Protonerd/DIYino/pictures/hasbro_LS_openDIYinoinChassis_zpsviki0zha.jpg

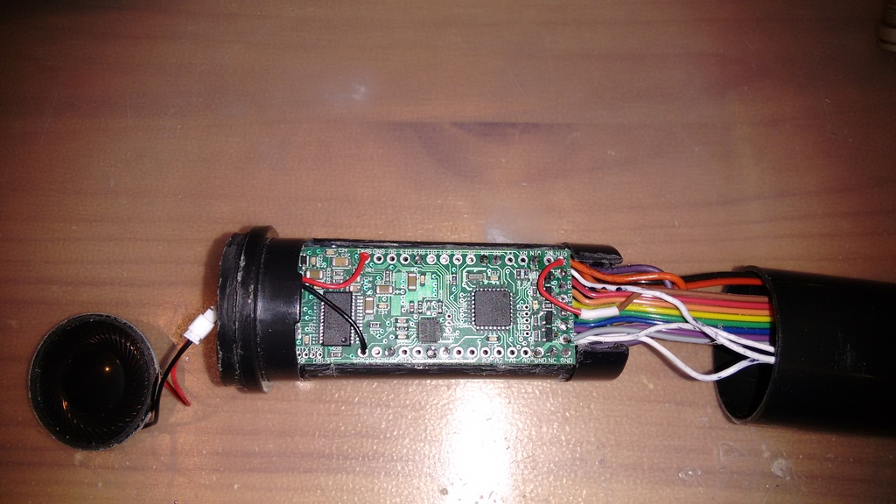
pictures/hasbro_LS_openDIYinoinChassis_zpsviki0zha.jpg
