Protonerd/DIYino/pictures/kicsi_IMG_20170122_215109895_00010_zpswzbyonry.jpg

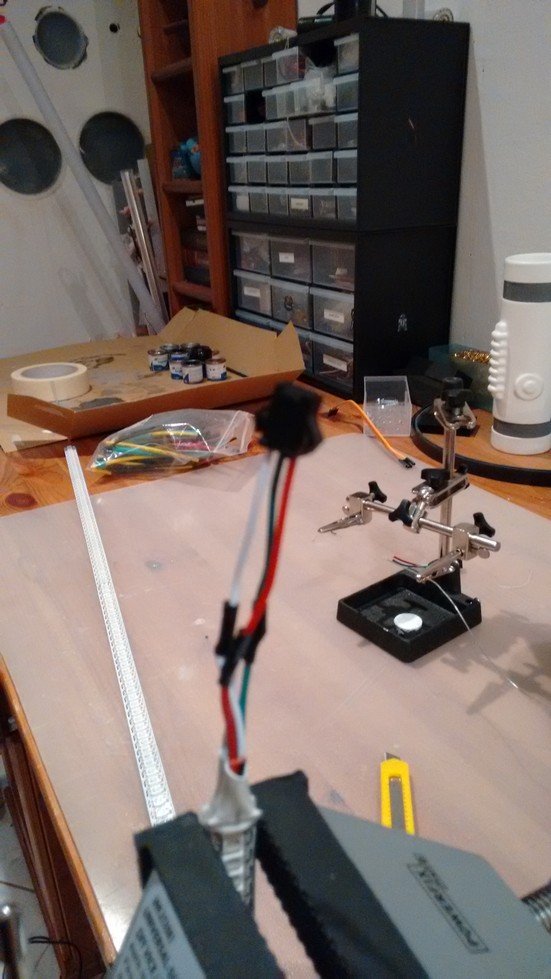
pictures/kicsi_IMG_20170122_215109895_00010_zpswzbyonry.jpg
