Protonerd/DIYino/pictures/Blaster_Display_Layout_zpsyfktzud1.jpg

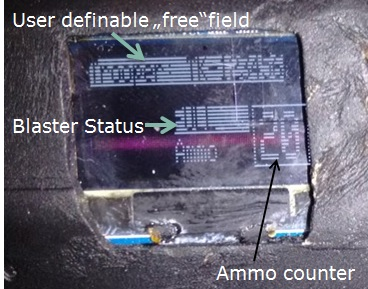
pictures/Blaster_Display_Layout_zpsyfktzud1.jpg
