Protonerd/DIYino/pictures/DIYino_1v5_1_zps3bcdqgek.jpg

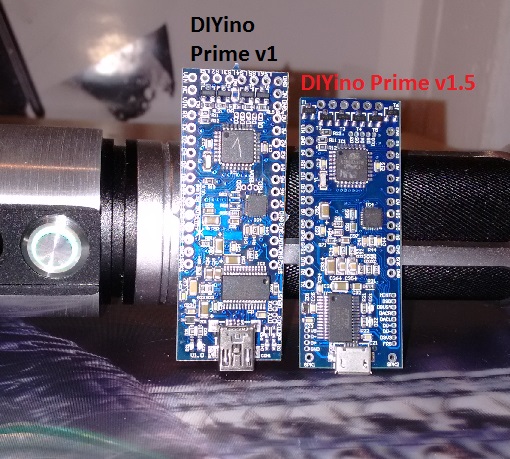
pictures/DIYino_1v5_1_zps3bcdqgek.jpg
