Protonerd/DIYino/pictures/DIYino_1v5_2_zpsymannivk.jpg

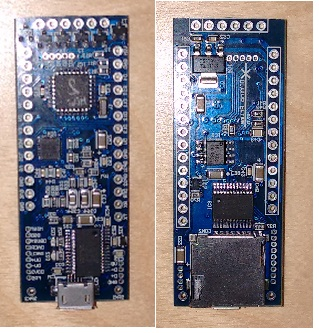
pictures/DIYino_1v5_2_zpsymannivk.jpg
