Protonerd/DIYino/pictures/DIYino_blaster_modules_zps4i7b7zbh.jpg

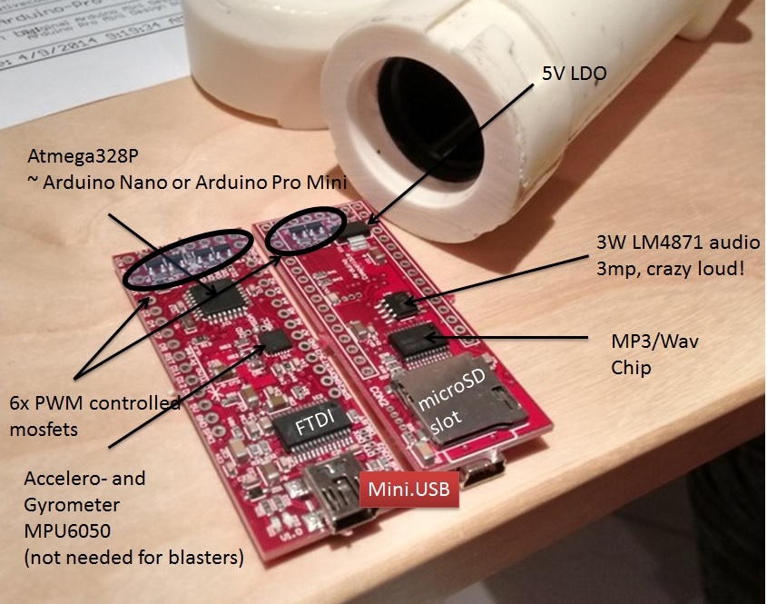
pictures/DIYino_blaster_modules_zps4i7b7zbh.jpg
