Protonerd/DIYino/pictures/DIYino_placement_v1_zpsvjuz00kw.jpg

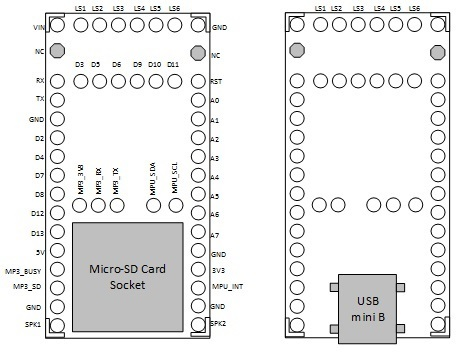
pictures/DIYino_placement_v1_zpsvjuz00kw.jpg
