Protonerd/DIYino/pictures/DIYino_Stardustv1_front_zpssht71tzs.jpg

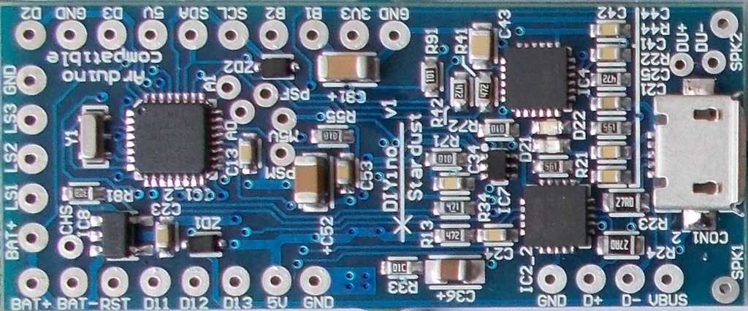
pictures/DIYino_Stardustv1_front_zpssht71tzs.jpg
