Protonerd/DIYino/pictures/DIYinobottom_zpsivflhri3.jpg

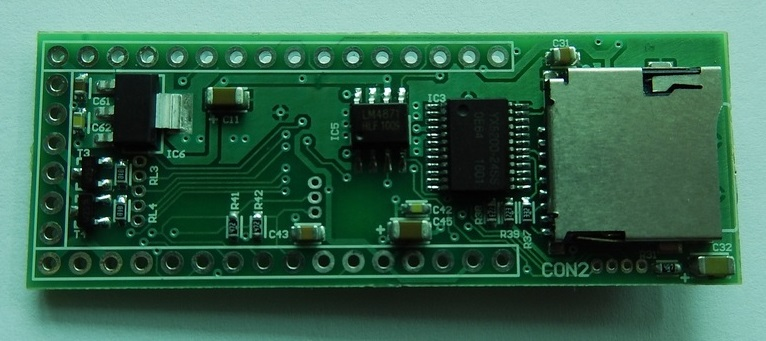
pictures/DIYinobottom_zpsivflhri3.jpg
