Protonerd/DIYino/pictures/DIYinotop_zpsscddceel.jpg

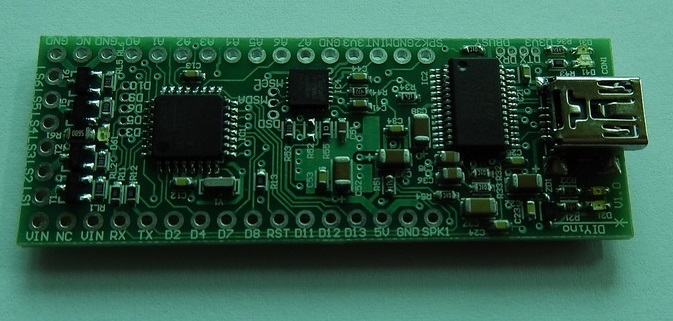
pictures/DIYinotop_zpsscddceel.jpg
