Protonerd/DIYino/pictures/DSC_4505_zpsdudptq5h.jpg

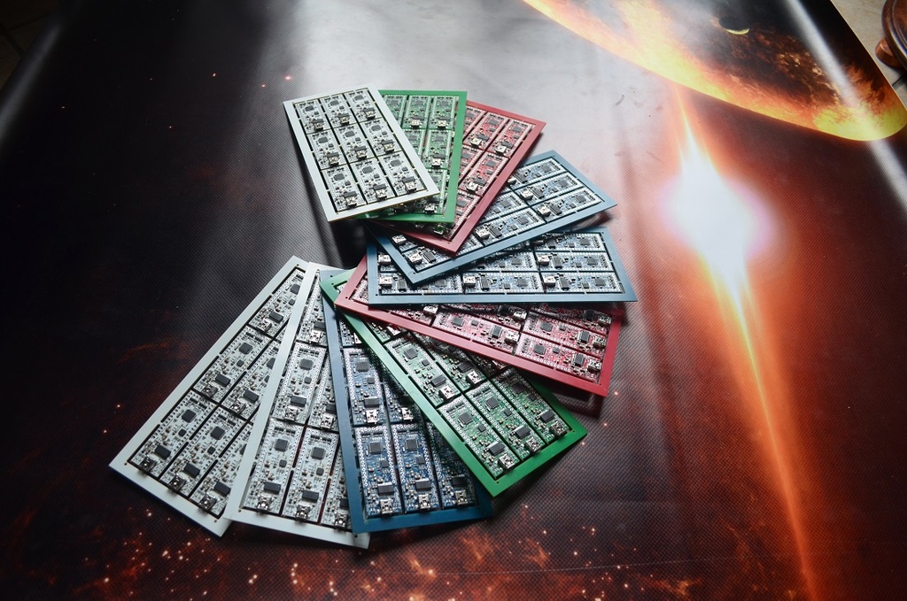
pictures/DSC_4505_zpsdudptq5h.jpg
