Protonerd/DIYino/pictures/DSC_4589 2_zpskc2gelkp.jpg

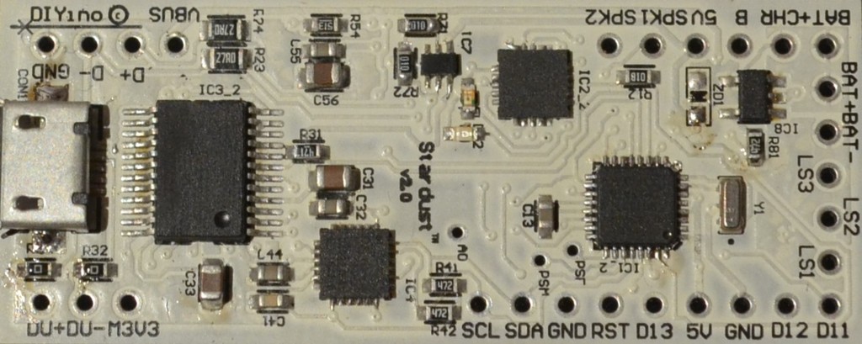
pictures/DSC_4589 2_zpskc2gelkp.jpg
