Protonerd/DIYino/pictures/DSC_4593 2_zpslnhpkdew.jpg

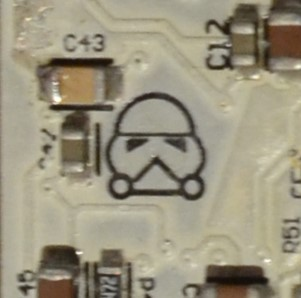
pictures/DSC_4593 2_zpslnhpkdew.jpg
