Protonerd/DIYino/pictures/DSC_4595 2_zpsk5upttnt.jpg

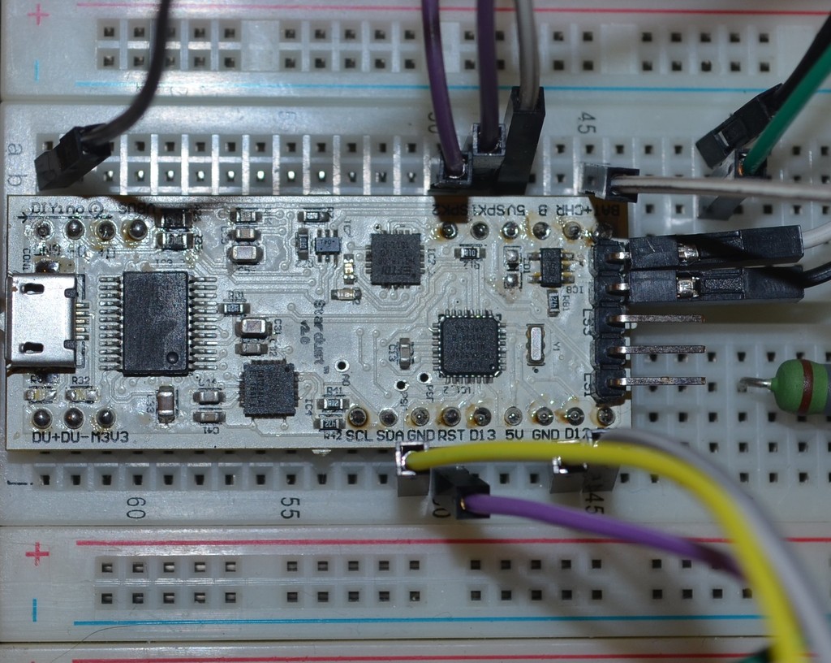
pictures/DSC_4595 2_zpsk5upttnt.jpg
