Protonerd/DIYino/pictures/DSCN0511_zpstvpl7wgr.jpg

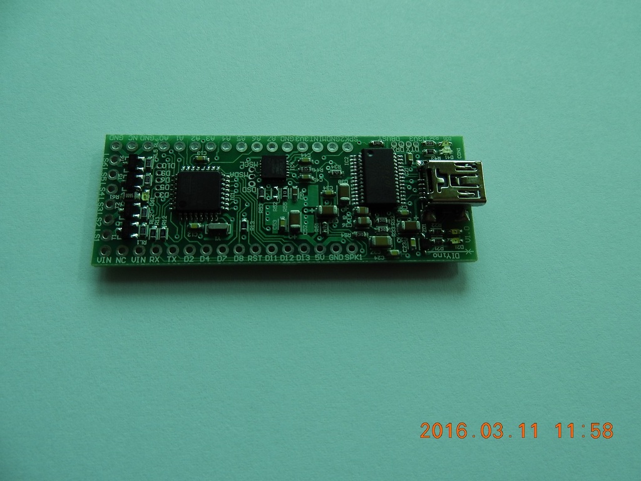
pictures/DSCN0511_zpstvpl7wgr.jpg
