Protonerd/DIYino/pictures/DSCN0513_zpsl67sjnq8.jpg

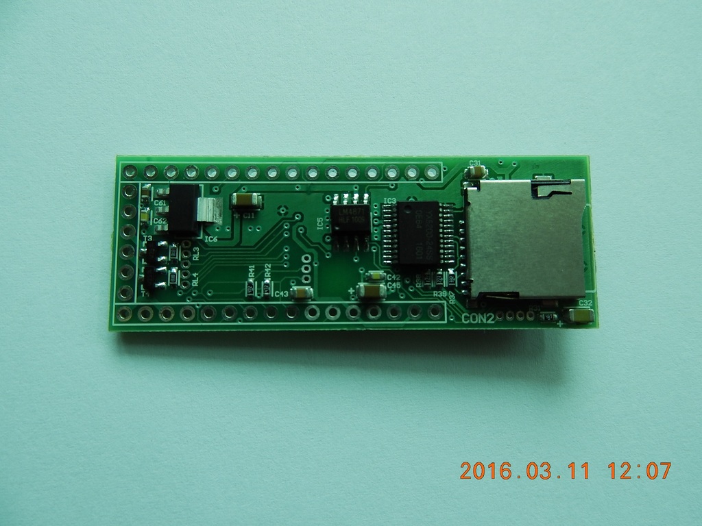
pictures/DSCN0513_zpsl67sjnq8.jpg
