Protonerd/DIYino/pictures/hasbro_LS_RCport_front_zpssrq27ork.jpg

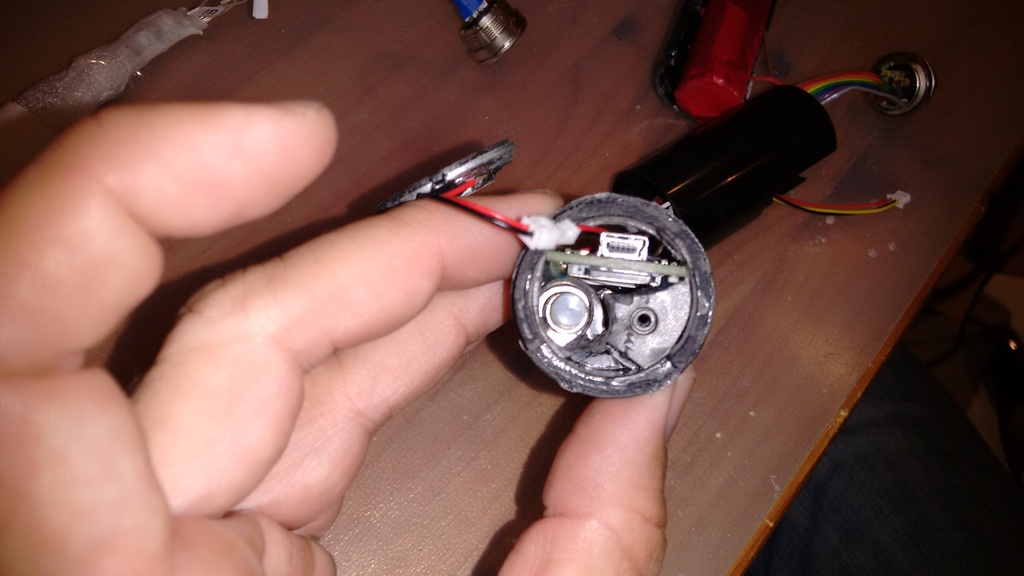
pictures/hasbro_LS_RCport_front_zpssrq27ork.jpg
