Protonerd/DIYino/pictures/IMG_20160215_192625701_zpswwhzhes4.jpg

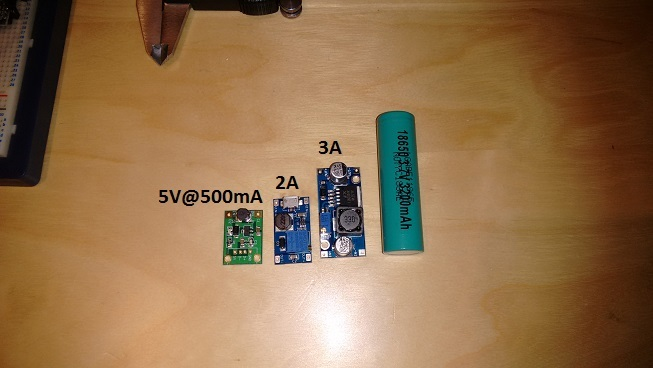
pictures/IMG_20160215_192625701_zpswwhzhes4.jpg
