Protonerd/DIYino/pictures/IMG_20160817_222459960_zpsyy1zh1ps.jpg

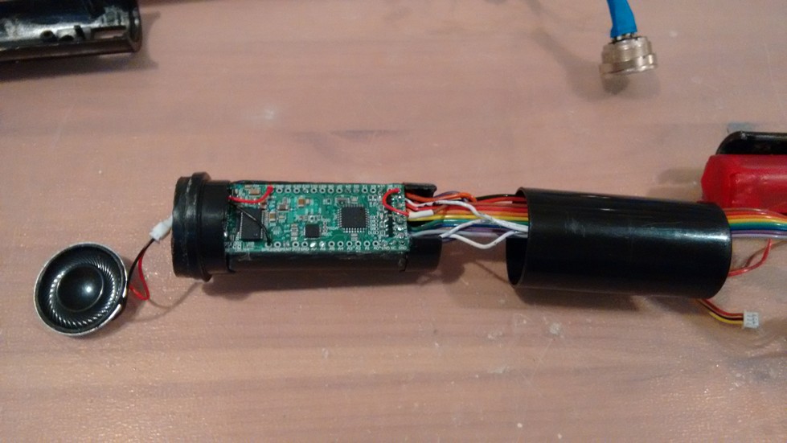
pictures/IMG_20160817_222459960_zpsyy1zh1ps.jpg
