Protonerd/DIYino/pictures/IMG_20160817_222520294_zpsochgfkhs.jpg

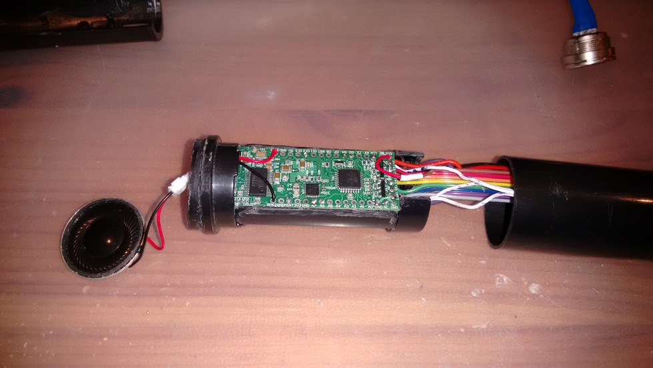
pictures/IMG_20160817_222520294_zpsochgfkhs.jpg
