Protonerd/DIYino/pictures/IMG_20160903_123718477_zpshqtb2i5k.jpg

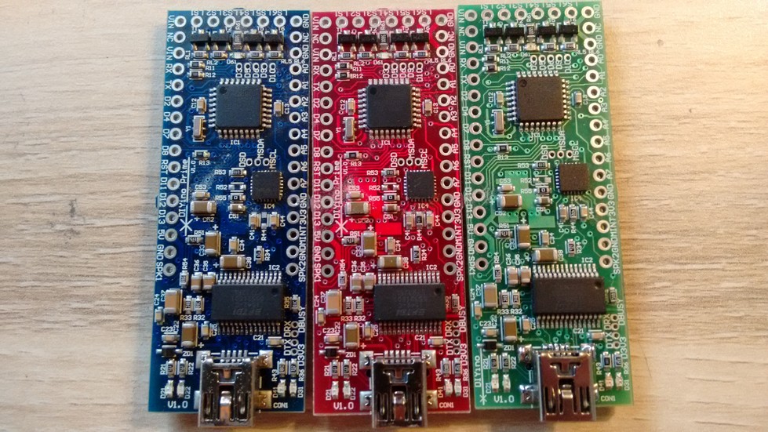
pictures/IMG_20160903_123718477_zpshqtb2i5k.jpg
