Protonerd/DIYino/pictures/IMG_20160903_124019020_zps9ozfazle.jpg

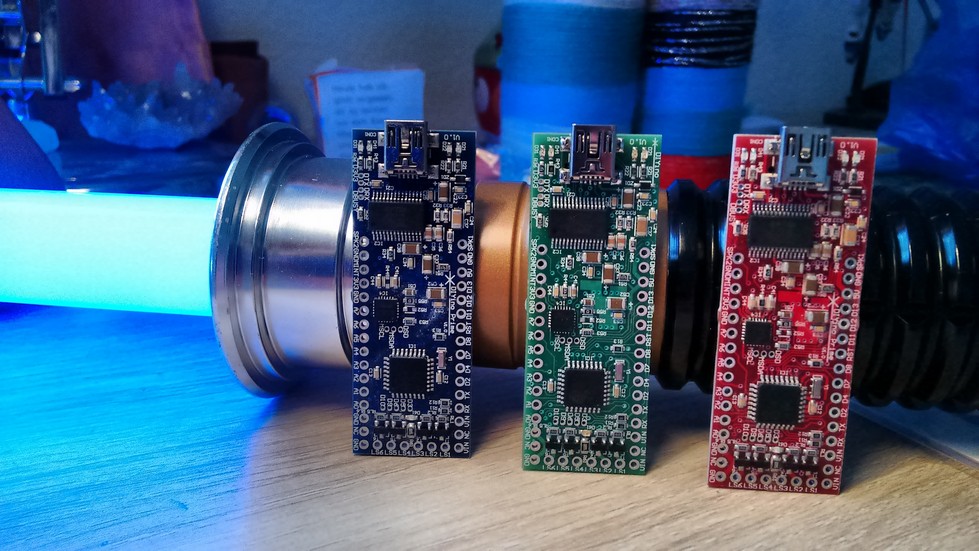
pictures/IMG_20160903_124019020_zps9ozfazle.jpg
