Protonerd/DIYino/pictures/IMG_20160903_124147270_HDR_zpsfaebn9b1.jpg

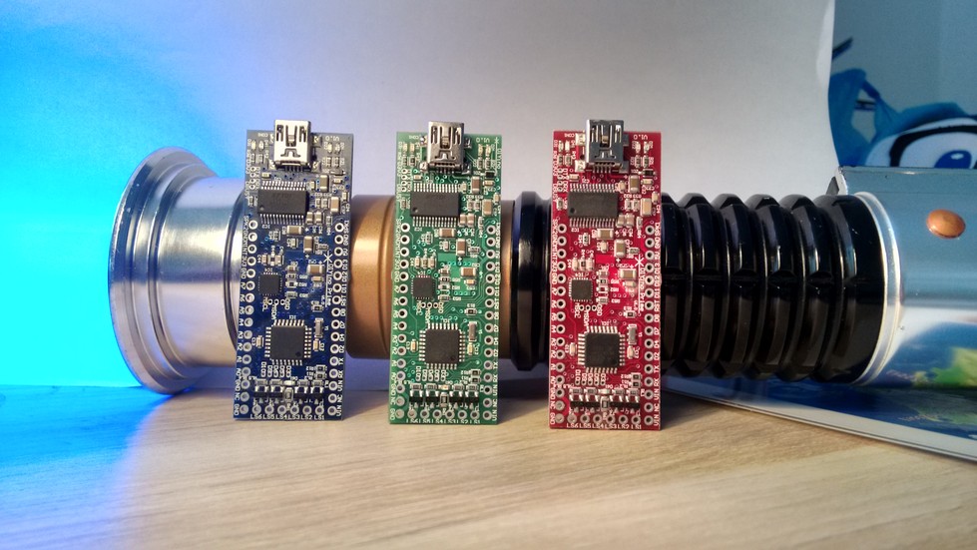
pictures/IMG_20160903_124147270_HDR_zpsfaebn9b1.jpg
