Protonerd/DIYino/pictures/IMG_20160903_190137795_zpsxg9ac361.jpg

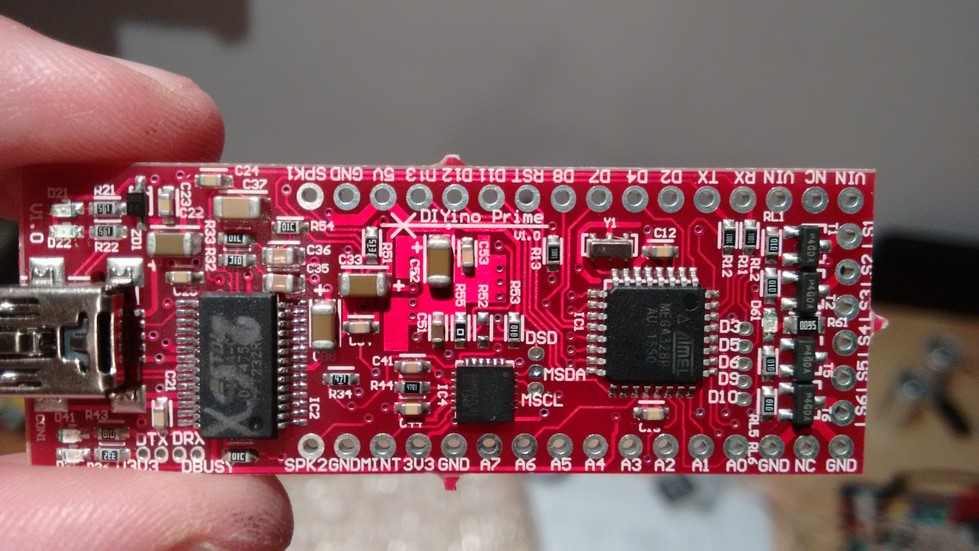
pictures/IMG_20160903_190137795_zpsxg9ac361.jpg
