Protonerd/DIYino/pictures/IMG_20170108_090120063_zps22bmebdj.jpg

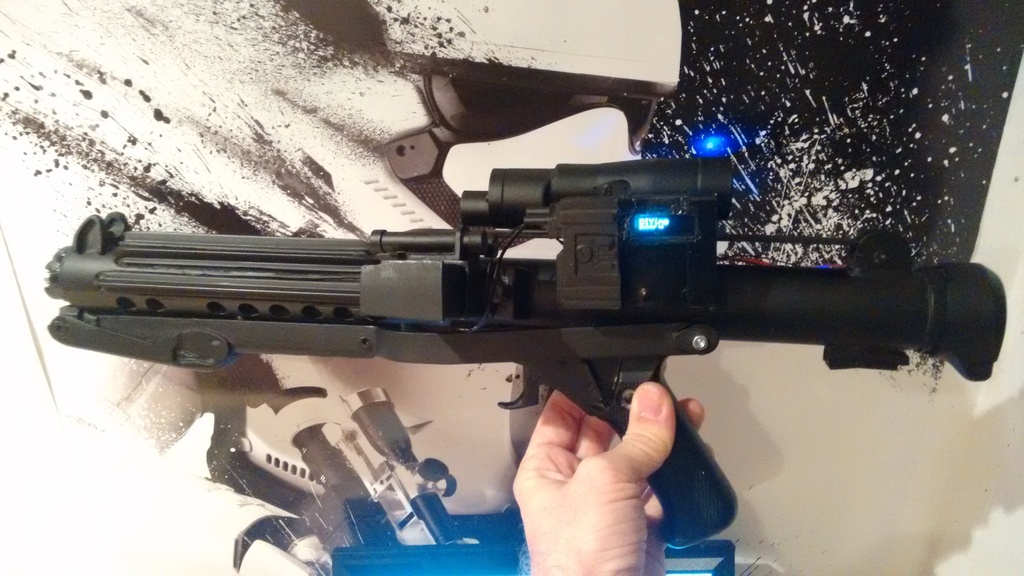
pictures/IMG_20170108_090120063_zps22bmebdj.jpg
