Protonerd/DIYino/pictures/IMG_20170108_090247453_zpsiayvx3zq.jpg

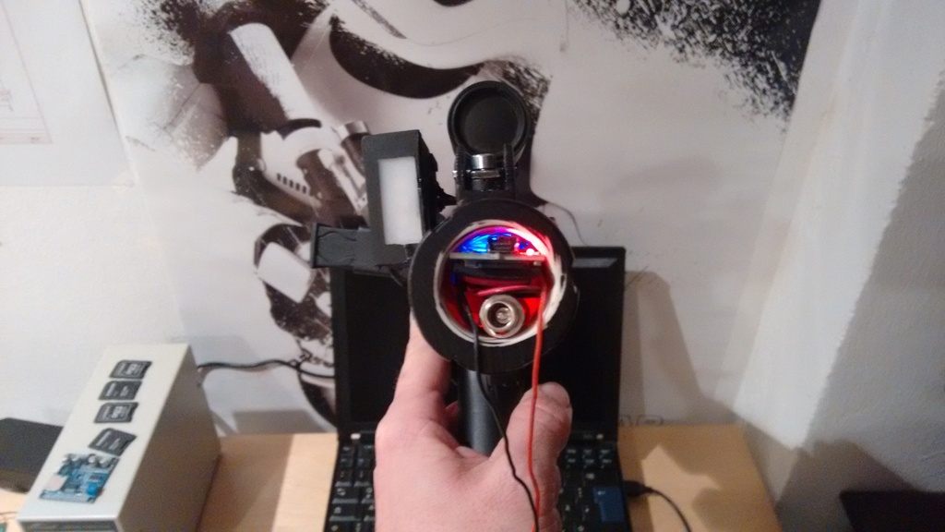
pictures/IMG_20170108_090247453_zpsiayvx3zq.jpg
