Protonerd/DIYino/pictures/IMG_20170303_185319780_zpsg4lbf3bk.jpg

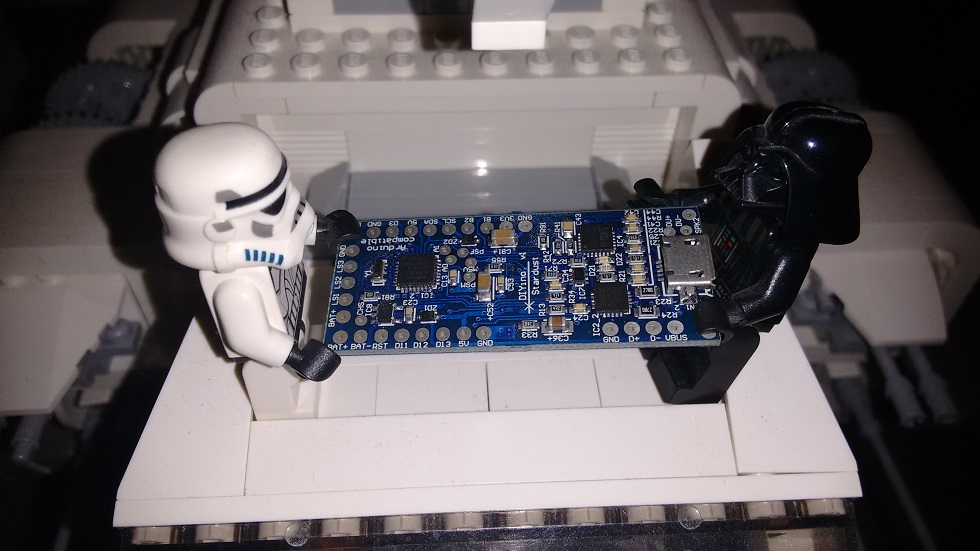
pictures/IMG_20170303_185319780_zpsg4lbf3bk.jpg
