Protonerd/DIYino/pictures/IMG_20170303_185423301_zpsorqcnlbd.jpg

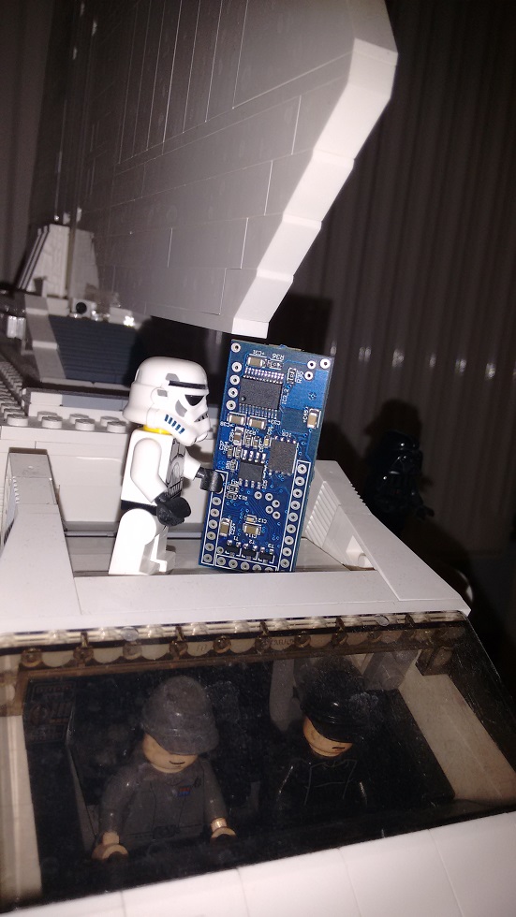
pictures/IMG_20170303_185423301_zpsorqcnlbd.jpg
