Protonerd/DIYino/pictures/IMG_20170303_185547586_zpsnakpmyop.jpg

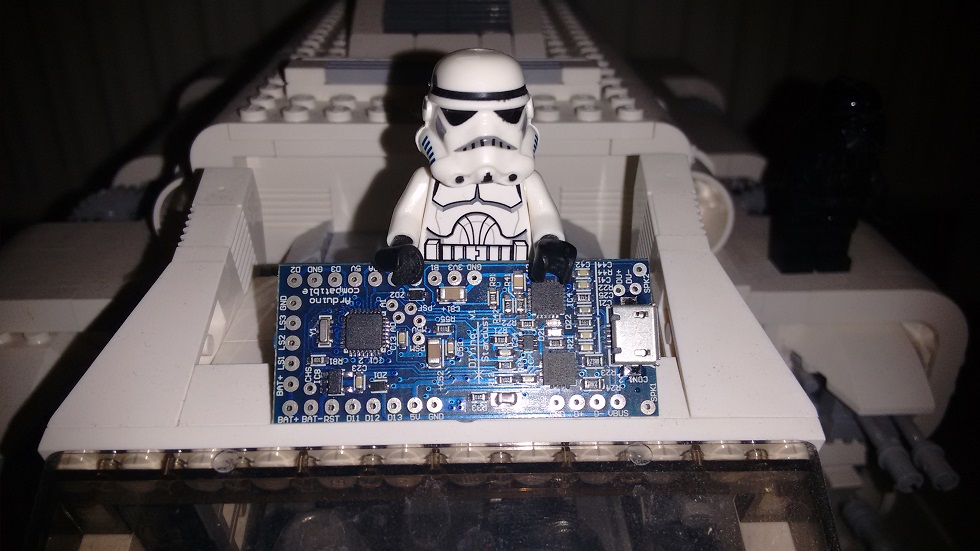
pictures/IMG_20170303_185547586_zpsnakpmyop.jpg
