Protonerd/DIYino/pictures/IMG_20170419_100204555_zps6a7qe6bl.jpg

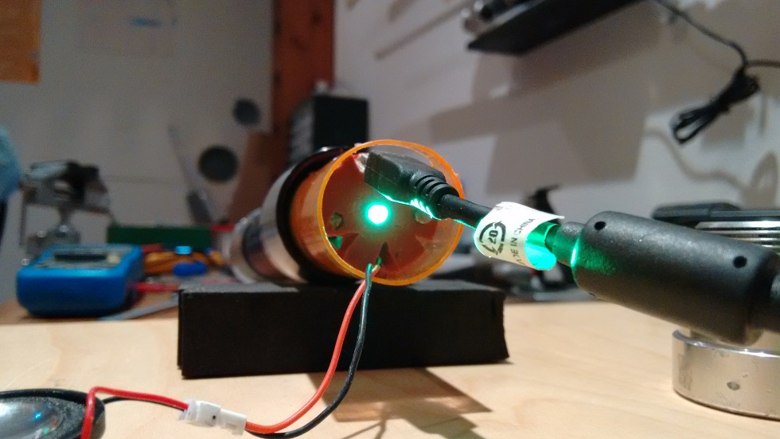
pictures/IMG_20170419_100204555_zps6a7qe6bl.jpg
