Protonerd/DIYino/pictures/IMG_20170419_100227607_zpsmmdsqt12.jpg

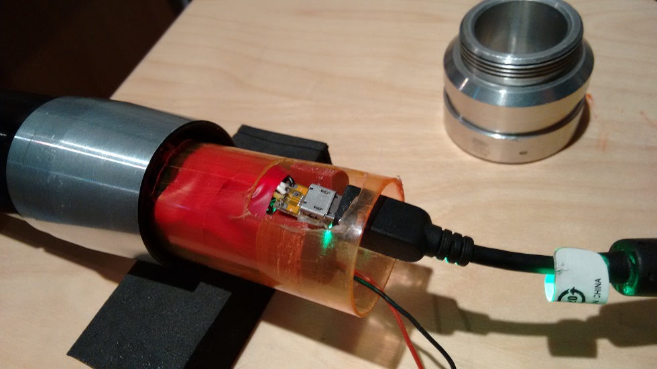
pictures/IMG_20170419_100227607_zpsmmdsqt12.jpg
