Protonerd/DIYino/pictures/kicsi_IMG_20170122_212320088_00005_zpsohwptpz7.jpg

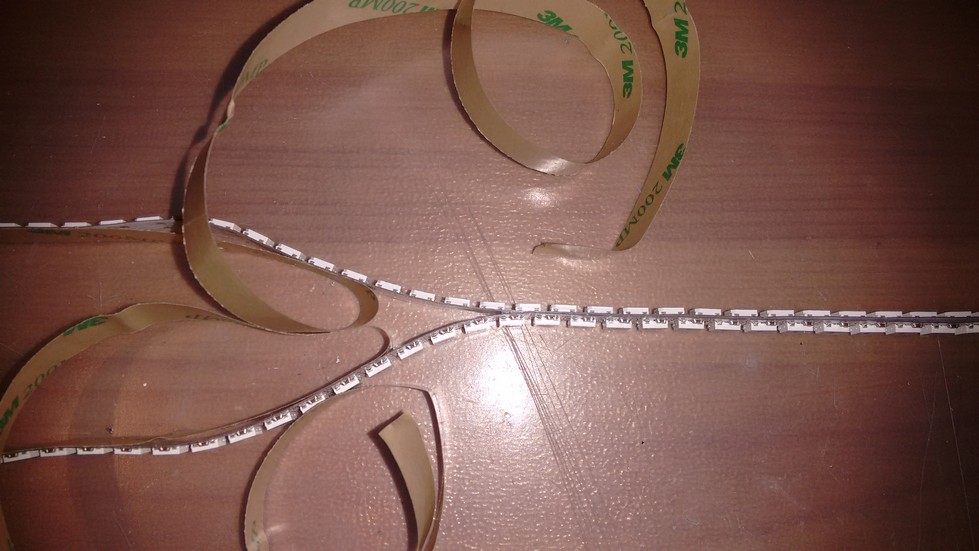
pictures/kicsi_IMG_20170122_212320088_00005_zpsohwptpz7.jpg
