Protonerd/DIYino/pictures/kicsi_IMG_20170122_212332006_00006_zpsjkgaviow.jpg

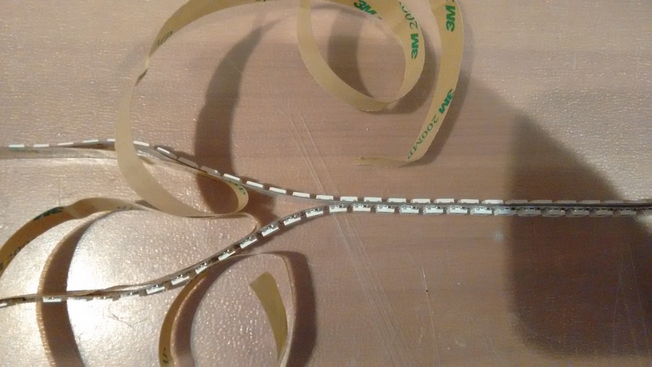
pictures/kicsi_IMG_20170122_212332006_00006_zpsjkgaviow.jpg
