Protonerd/DIYino/pictures/kicsi_IMG_20170122_215031621_00008_zpsc7vpzqku.jpg

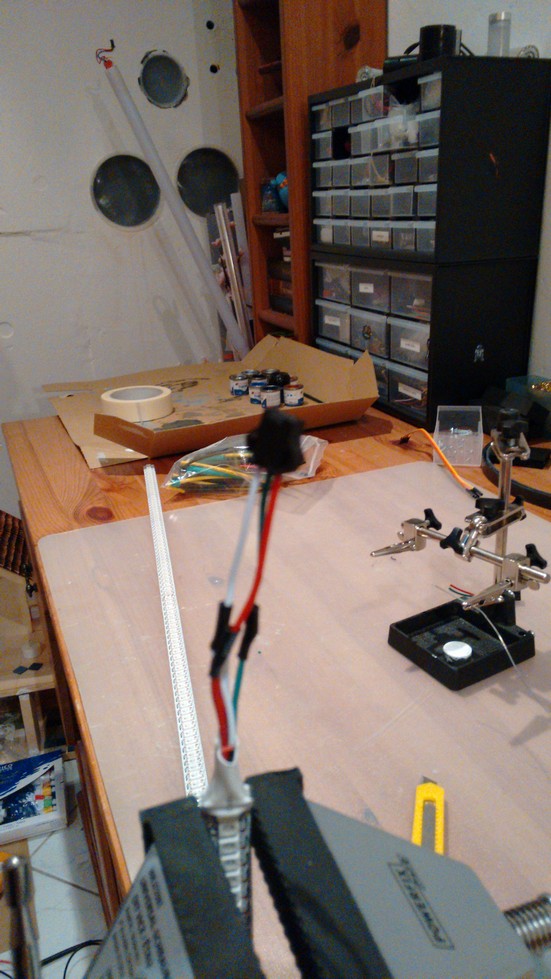
pictures/kicsi_IMG_20170122_215031621_00008_zpsc7vpzqku.jpg
