Protonerd/DIYino/pictures/kicsi_IMG_20170122_215148172_00011_zpsugg8ep5e.jpg

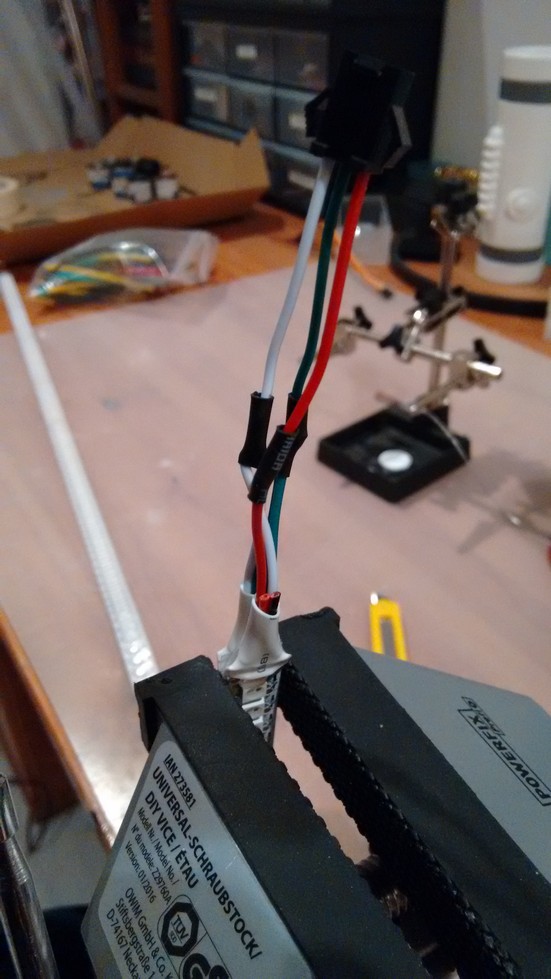
pictures/kicsi_IMG_20170122_215148172_00011_zpsugg8ep5e.jpg
