Protonerd/DIYino/pictures/kicsi_IMG_20170122_215158989_00012_zpsqsmlgti9.jpg

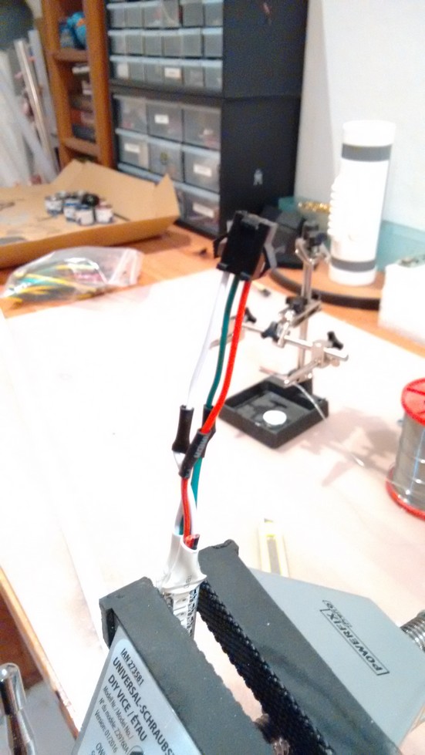
pictures/kicsi_IMG_20170122_215158989_00012_zpsqsmlgti9.jpg
