Protonerd/DIYino/pictures/kicsi_IMG_20170122_220129656_00013_zps1cooiyib.jpg

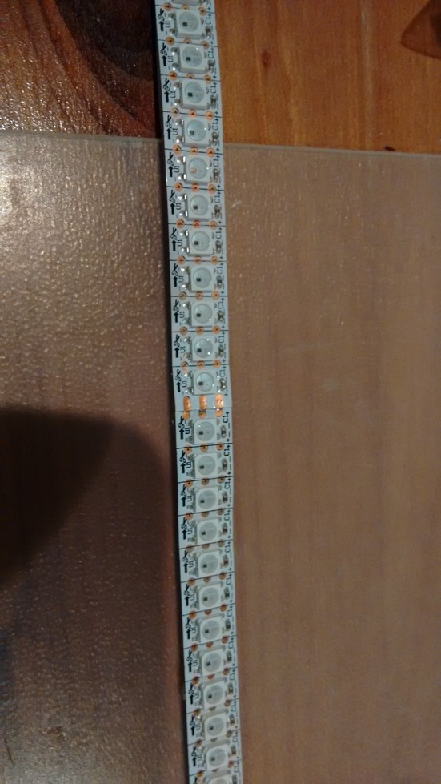
pictures/kicsi_IMG_20170122_220129656_00013_zps1cooiyib.jpg
