Protonerd/DIYino/pictures/kicsi_IMG_20170122_220132977_00014_zpskxxajvfy.jpg

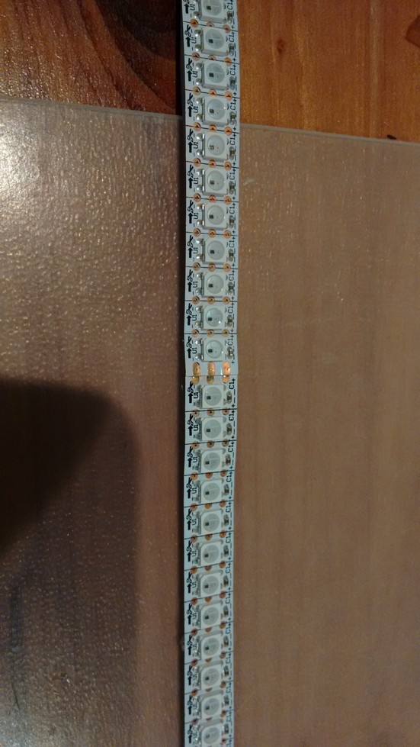
pictures/kicsi_IMG_20170122_220132977_00014_zpskxxajvfy.jpg
