Protonerd/DIYino/(threads)

Thread 1 (2016-06-17):

Add bootloader info

Papiertig0r, 2016-06-17:
In the "DIYino_v1_User_Manual_draft_v03.pdf" is no information which setting you have to use in the Arduino IDE to succesfully upload sketches.

Papiertig0r, 2016-06-17:
Please don't mind, I just realized it's a draft, sorry!

Protonerd, 2016-06-20:
Hi Papiertig0r, I will certainly work also on that Chapter but due to the superb documentation on the Arduino site I will only add links and not describe it in detail. Arduino is part of what DIYino is, but it's a hardware and I can only give some general guidelines/quick start help for software development.

Protonerd, 2016-06-20:
Oh, I realized I might have misunderstood your intent. Probably you referred to the setting which type of circuit to use.. it is the Nano.

Closed 2016-06-20.

Thread 2 (2016-06-20):

MPU6050 clash detection - works but no clue why?

Protonerd, 2016-06-20:
Hi neskweek,
Yesterday I've been experimenting again with the clash detection, because it still seems to be not as responsive as it should be. I looked at the code and also read the MPU6050 Manual, all about motion interrupts.

It seems there are only 4 parameters playing a roles:

These settings change the full scale range of the accelero/gyro (not yet in LSOS...). These should change the sensitivity of the saber because an LSB is scaled with full range.
        // set the fll scale range of the gyro- and accelerometer respectively
        mpu.setFullScaleGyroRange(0); //0: 250deg/s | 1: 500deg/s | 2: 1000deg/s | 3: 2000deg/s
        mpu.setFullScaleAccelRange(0); //0: 2g | 1: 4g | 2: 8g | 3: 16g

Then there are the settings for the motion interrupt. The first one sets the threshold, but no idea how...I guess the number means LSB. But it's strange, with a setting of 10, we should hear clash triggering all the time even if we just shudder.
        mpu.setMotionDetectionThreshold(10); // 1mg/LSB
	mpu.setMotionDetectionDuration(1); // number of consecutive samples above threshold to trigger int

I experimented with following things (using 2 sabers both with DIYino):
- set mpu.setFullScaleAccelRange(0) and mpu.setFullScaleGyroRange(0) once to 0 and once to 3 (2 extreme values) -> no change in the clash detection, no tangible effect on other motion detection
- play with mpu.setMotionDetectionDuration(1) -> no change in clash detection

Funny thing is, my LED string saber is no (without any change) very responsive, even small taps will trigger clash (the right way!), while my new neopixel saber (using also DIYino) sometimes even fail to detect quite hard hits...I re-calibrated both MPUs and also tried with a sketch what they read, they read and are calibrated both perfectly.

So I feel we still do not fully understand how this motion interrupt feature works...although clash is by far the most important feature of a saber (besides the LEDs).

It is more a fundamental topic, not an immediate bug, but I did not find a better place to report/discuss.

Cheers: Andras

Protonerd, 2016-06-20:
sorry. wrongly opened issue, this belongs to LSOS

Closed 2016-06-20.

Thread 3 (2017-05-22):

burnt MOSFET

Argathena, 2017-05-22:
Not sure how, but I managed to burn off LS1 MOSFET. I only use 3 of the MOSFETs to power a tri rebel luxeon with 2 blue and 1 white. I rewired my led that was on LS1 to LS4. When I power on now it makes the initial noise of speaker being powered, but no sound. Neither the start up or the hum, but the lights work (kind of). Do the MOSFETs affect sound at all? Or is it simply in the code? (LSOS V1.0) Im not sure if LSOS makes sure the MOSFETs are working, like it does for the MPU. I need to buy another one anyway but I'm on a tight budget right now. 200 days til episode 8 and I need one working lol

Closed 2017-10-26.
