Protonerd/DIYino/(commit log)

2016-07-07 Add files via upload
    new version of the User Manual including a description and wiring of LED strings
    Full wiring diagram for LED strings using Serial II. technique and HP-LED with 5V DC/DC
2016-12-04 Added MPU calibration function
    Original from Rodena and Rowberg, modified to enable writing the calibration values to the EEPROM of the Atmega328P. Moreover Limits are relaxed and the Progress of the calibration is logged.
2017-02-27 replace EEPROM start address of MPU calib values to make room for LSOS 1.5 extended set of parameters stored in EEROM
    [MPU6050_calibration.ino]
2017-09-19 added getting started chapter
    to make it easier for users to start interacting with the board
2017-12-01 hint about plugging in to on-board USB port
